AxxAxx/AxxPD/Documentation/photos/AxxPD_Schematic.png

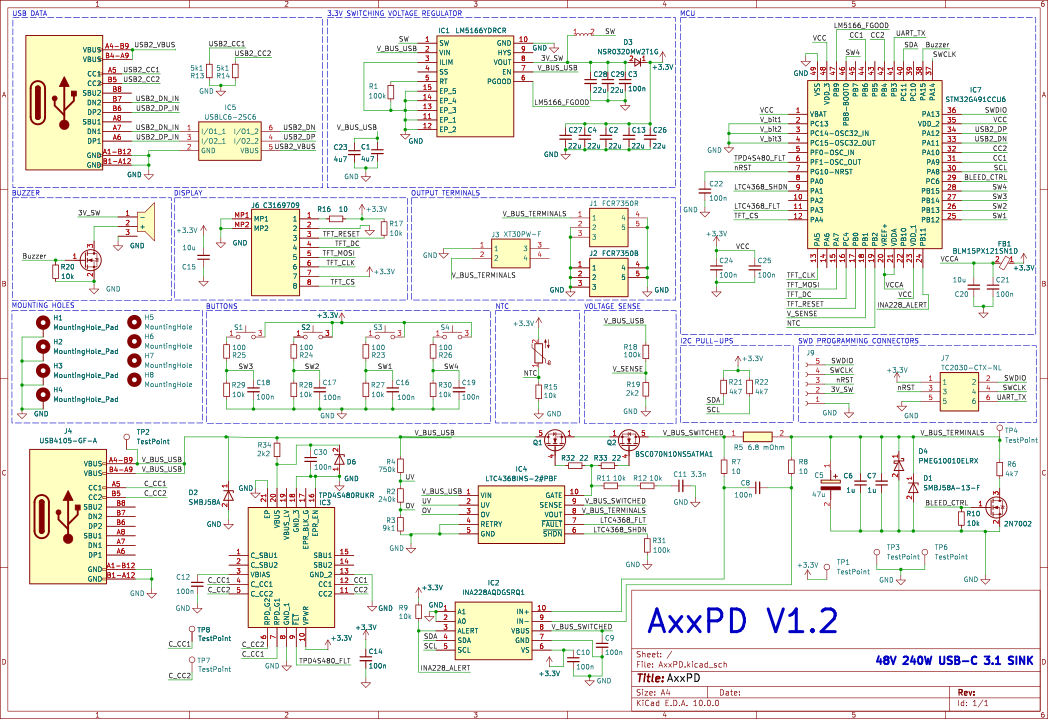
Documentation/photos/AxxPD_Schematic.png
