AxxAxx/AxxPD/Firmware/Core/Inc/main.h

#define FAULT_NONE            0
#define FAULT_INA228_OCP      1
#define FAULT_COMP_OVP        2
#define FAULT_LTC4368         3
#define FAULT_TPD4S480        4
#define FAULT_LM5166_PGOOD    5
#define FAULT_OPP             6
#define FAULT_TIMER           7
#define FAULT_AH_LIMIT        8
#define FAULT_WH_LIMIT        9
#define FAULT_CHARGE_COMPLETE 10
#define FAULT_THERMAL         11
#define FAULT_LOG_SIZE  8
#define V_BIT_1_Pin GPIO_PIN_13
#define V_BIT_1_GPIO_Port GPIOC
#define V_BIT_2_Pin GPIO_PIN_14
#define V_BIT_2_GPIO_Port GPIOC
#define V_BIT_3_Pin GPIO_PIN_15
#define V_BIT_3_GPIO_Port GPIOC
#define TPD4S480_FLT_Pin GPIO_PIN_1
#define TPD4S480_FLT_GPIO_Port GPIOF
#define LTC4368_SHDN_Pin GPIO_PIN_1
#define LTC4368_SHDN_GPIO_Port GPIOA
#define LTC4368_FLT_Pin GPIO_PIN_3
#define LTC4368_FLT_GPIO_Port GPIOA
#define TFT_CS_Pin GPIO_PIN_4
#define TFT_CS_GPIO_Port GPIOA
#define TFT_DC_Pin GPIO_PIN_4
#define TFT_DC_GPIO_Port GPIOC
#define TFT_RESET_Pin GPIO_PIN_0
#define TFT_RESET_GPIO_Port GPIOB
#define V_SENSE_Pin GPIO_PIN_1
#define V_SENSE_GPIO_Port GPIOB
#define NTC_Pin GPIO_PIN_2
#define NTC_GPIO_Port GPIOB
#define INA228_ALERT_Pin GPIO_PIN_11
#define INA228_ALERT_GPIO_Port GPIOB
#define SW_1_Pin GPIO_PIN_12
#define SW_1_GPIO_Port GPIOB
#define SW_2_Pin GPIO_PIN_13
#define SW_2_GPIO_Port GPIOB
#define SW_3_Pin GPIO_PIN_14
#define SW_3_GPIO_Port GPIOB
#define SW_4_Pin GPIO_PIN_15
#define SW_4_GPIO_Port GPIOB
#define BLEED_CTRL_Pin GPIO_PIN_6
#define BLEED_CTRL_GPIO_Port GPIOC
#define BUZZER_Pin GPIO_PIN_15
#define BUZZER_GPIO_Port GPIOA
#define LM5166_FGOOD_Pin GPIO_PIN_9
#define LM5166_FGOOD_GPIO_Port GPIOB
#define VERSION_BIT_1_Pin       V_BIT_1_Pin
#define VERSION_BIT_1_GPIO_Port V_BIT_1_GPIO_Port
#define VERSION_BIT_2_Pin       V_BIT_2_Pin
#define VERSION_BIT_2_GPIO_Port V_BIT_2_GPIO_Port
#define VERSION_BIT_3_Pin       V_BIT_3_Pin
#define VERSION_BIT_3_GPIO_Port V_BIT_3_GPIO_Port
#define BUTTON_DECREASE_Pin       SW_3_Pin
#define BUTTON_DECREASE_GPIO_Port SW_3_GPIO_Port
#define BUTTON_INCREASE_Pin       SW_2_Pin
#define BUTTON_INCREASE_GPIO_Port SW_2_GPIO_Port
#define BUTTON_SELECT_Pin         SW_1_Pin
#define BUTTON_SELECT_GPIO_Port   SW_1_GPIO_Port
#define BUTTON_POWER_Pin          SW_4_Pin
#define BUTTON_POWER_GPIO_Port    SW_4_GPIO_Port
#define LM5166_PGOOD_Pin          LM5166_FGOOD_Pin
#define LM5166_PGOOD_GPIO_Port    LM5166_FGOOD_GPIO_Port
#define OVP_DIVIDER_RATIO (2.2f / (100.0f + 2.2f))
