AxxAxx/AxxPD/Firmware/pdsink/src/pd/dpm.cpp

#include <etl/algorithm.h>

#include "dpm.h"
#include "pd_log.h"
#include "port.h"
#include "utils/dobj_utils.h"

// [AxxPD fix 2026-08-02] CMSIS intrinsics (__get_PRIMASK / __disable_irq /
// __set_PRIMASK) for the trigger-setter critical sections below.
#include "stm32g4xx.h"

namespace pd {

using namespace dobj_utils;

//
// Custom handlers. You are expected to override these in your application.
//

auto DPM::get_sink_pdo_list() -> PDO_LIST {
    // SNK demands are filled only once and MUST NOT be changed
    if (sink_pdo_list.size() > 0) { return sink_pdo_list; }

    //
    // By default, demand as much as possible. Otherwise the SRC can
    // hide some capabilities. This list does NOT depend on the SRC and
    // exists to describe SNK needs.
    //
    // NOTE: This can be just a list of uint32_t constants, but for better
    // readability we use PDO structures to fill the data.
    //

    //
    // SPR PDOs first. Fixed ones first, ordered by voltage. Then PPS.
    //

    // See [rev3.2] 6.4.1.3 Sink Power Data Objects
    SNK_PDO_FIXED pdo1{create_pdo_variant_bits(PDO_VARIANT::FIXED)};

    // PDO 1 is always vSafe5V, with extra flags to describe demands.
    // NOTE: These flags should be zero in following PDO-s
    pdo1.dual_role_power = 0; // No DRP support, Sink only
    pdo1.higher_capability = 1; // Require more power for full functionality
    pdo1.unconstrained_power = 1;
    if (has_usb_comm()) { pdo1.usb_comms_capable = 1; }
    pdo1.dual_role_data = 0; // No DFP support, UFP only
    pdo1.frs_required = 0; // No FRS support

    set_snk_pdo_limits(pdo1.raw_value, PDO_LIMITS().set_mv(5000).set_ma(3000));
    sink_pdo_list.push_back(pdo1.raw_value);

    //
    // Fill the rest of the SPR PDOs, 2...7
    //
    SNK_PDO_FIXED pdo2{create_pdo_variant_bits(PDO_VARIANT::FIXED)};
    set_snk_pdo_limits(pdo2.raw_value, PDO_LIMITS().set_mv(9000).set_ma(3000));
    sink_pdo_list.push_back(pdo2.raw_value);

    SNK_PDO_FIXED pdo3{create_pdo_variant_bits(PDO_VARIANT::FIXED)};
    set_snk_pdo_limits(pdo3.raw_value, PDO_LIMITS().set_mv(12000).set_ma(3000));
    sink_pdo_list.push_back(pdo3.raw_value);

    SNK_PDO_FIXED pdo4{create_pdo_variant_bits(PDO_VARIANT::FIXED)};
    set_snk_pdo_limits(pdo4.raw_value, PDO_LIMITS().set_mv(15000).set_ma(3000));
    sink_pdo_list.push_back(pdo4.raw_value);

    SNK_PDO_FIXED pdo5{create_pdo_variant_bits(PDO_VARIANT::FIXED)};
    set_snk_pdo_limits(pdo5.raw_value, PDO_LIMITS().set_mv(20000).set_ma(5000));
    sink_pdo_list.push_back(pdo5.raw_value);

    // PPS APDOs — minimum 3.3 V per PD spec, but many chargers only go to 5 V.
    SNK_PDO_SPR_PPS pdo6{create_pdo_variant_bits(PDO_VARIANT::APDO_PPS)};
    set_snk_pdo_limits(pdo6.raw_value,
        PDO_LIMITS().set_mv_min(5000).set_mv_max(11000).set_ma(3000));
    sink_pdo_list.push_back(pdo6.raw_value);

    SNK_PDO_SPR_PPS pdo7{create_pdo_variant_bits(PDO_VARIANT::APDO_PPS)};
    set_snk_pdo_limits(pdo7.raw_value,
        PDO_LIMITS().set_mv_min(5000).set_mv_max(21000).set_ma(5000));
    sink_pdo_list.push_back(pdo7.raw_value);

    //
    // EPR PDOs. MUST start from 8. If the SPR PDO count is < 7, the gap MUST be
    // padded with zeros. The EPR block can have up to 3 Fixed PDOs + 1 AVS.
    //

    SNK_PDO_FIXED pdo8{create_pdo_variant_bits(PDO_VARIANT::FIXED)};
    set_snk_pdo_limits(pdo8.raw_value, PDO_LIMITS().set_mv(28000).set_ma(5000));
    sink_pdo_list.push_back(pdo8.raw_value);

    SNK_PDO_FIXED pdo9{create_pdo_variant_bits(PDO_VARIANT::FIXED)};
    set_snk_pdo_limits(pdo9.raw_value, PDO_LIMITS().set_mv(36000).set_ma(5000));
    sink_pdo_list.push_back(pdo9.raw_value);

    SNK_PDO_FIXED pdo10{create_pdo_variant_bits(PDO_VARIANT::FIXED)};
    set_snk_pdo_limits(pdo10.raw_value, PDO_LIMITS().set_mv(48000).set_ma(5000));
    sink_pdo_list.push_back(pdo10.raw_value);

    SNK_PDO_EPR_AVS pdo11{create_pdo_variant_bits(PDO_VARIANT::APDO_EPR_AVS)};
    set_snk_pdo_limits(pdo11.raw_value,
        PDO_LIMITS().set_mv_min(15000).set_mv_max(48000).set_pdp(get_epr_watts()));
    sink_pdo_list.push_back(pdo11.raw_value);

    return sink_pdo_list;
}

void DPM::fill_rdo_flags(uint32_t &rdo) {
    // Fill common RDO flags here.
    // This is the default implementation. You can override it if required.

    RDO_ANY rdo_bits{rdo};

    // Mirror source PDO1 EPR bit — setting epr_capable=1 when the source
    // has EPR=0 causes a Hard Reset on strict chargers (PD 3.1 s6.4.2.4.3).
    //
    // Per USB-PD 3.1 Table 6.9 (Fixed Supply PDO – Source), bit 23 is
    // "EPR Mode Capable" (bit 22 is reserved). pdsink upstream incorrectly
    // extracts bit 22 here; use bit 23. The sink RDO's epr_capable bit is
    // at 22 (Table 6.23), so the union write below targets the correct bit.
    //
    // NOTE: we always mirror the source's bit, even when the sink doesn't
    // intend to enter EPR. Observed Anker A2697 behaviour: if our SPR
    // Request for the 20 V/5 A PDO sets epr_capable=0, Anker repeatedly
    // re-advertises Source_Capabilities instead of sending PS_RDY, in an
    // endless livelock. Declaring EPR capability truthfully (sink IS
    // EPR-capable; just not entering right now) satisfies the source.
    rdo_bits.epr_capable = (port.source_caps.size() > 0 &&
                            ((port.source_caps[0] >> 23) & 1)) ? 1 : 0;
    // Unchunked extended messages (long transfers) are NOT supported (and not
    // needed, because chunking is enough).
    // DON'T try to set this bit; it will break everything!
    rdo_bits.unchunked_ext_msg_supported = 0;
    rdo_bits.no_usb_suspend = 1;
    rdo_bits.usb_comm_capable = has_usb_comm() ? 1 : 0;

    rdo = rdo_bits.raw_value;
}

// This is called when `SRC Capabilities` and `EPR SRC Capabilities`
// are received from the power source. Returns the RDO and appropriate PDO as a pair
auto DPM::get_request_data_object(const etl::ivector<uint32_t>& src_caps) -> etl::pair<uint32_t, uint32_t> {
    // This is the default stub implementation, with simple trigger support.
    // Customize if required.

    //
    // NOTE: Here we indirectly check EPR mode. At the start we go to SPR, where
    // the EPR voltage will not be available, and we fall back to vSafe5V.
    // Then, PE will automatically upgrade to EPR (with new EPR Caps) and this
    // function will be called again.
    //

    if (src_caps.empty()) {
        DPM_LOGE("get_request_data_object: invalid SRC Caps input");
        return {0, 0};
    }

    for (uint32_t i = 0, max = src_caps.size(); i < max; i++) {
        const auto pdo = src_caps[i];
        // Skip padded positions
        if (pdo == 0) { continue; }

        const auto id = get_src_pdo_variant(pdo);
        // Skip unsupported PDO variants
        if (id == PDO_VARIANT::UNKNOWN) { continue; }

        if (trigger_match_type == TRIGGER_MATCH_TYPE::BY_POSITION)
        {
            // If the position matches, we can use it. Don't check ma/mv limits,
            // because the user asked for this position explicitly.
            // Note: position is 1-based.
            if ((i + 1) != trigger_position) { continue; }
        }
        else
        {
            if (trigger_match_type == TRIGGER_MATCH_TYPE::BY_PDO_VARIANT &&
                id != trigger_pdo_variant) { continue;}

            if (!match_limits(pdo, trigger_mv, trigger_ma)) { continue; }
        }

        // Create RDO
        RDO_ANY rdo{};
        fill_rdo_flags(rdo.raw_value);
        rdo.obj_position = i + 1; // zero-based index + 1

        // Fill PDO-specific fields (volts/current/watts)
        auto limits = get_src_pdo_limits(pdo);

        uint32_t mv = trigger_mv ? trigger_mv : limits.mv_min;
        mv = etl::clamp<uint32_t>(mv, limits.mv_min, limits.mv_max);

        uint32_t ma_limit = limits.ma ? limits.ma : (limits.pdp * 1000000U / mv);
        if (ma_limit > 5000) { ma_limit = 5000; } // clamp to 5A max PD limit

        uint32_t ma = trigger_ma ? trigger_ma : ma_limit;
        ma = etl::clamp<uint32_t>(ma, 0, ma_limit);

        switch (id) {
            case PDO_VARIANT::FIXED:
                // `mv` is always exact for FIXED PDO
                set_rdo_limits_fixed(rdo.raw_value, ma, ma);
                return {rdo.raw_value, pdo};

            case PDO_VARIANT::APDO_PPS:
                set_rdo_limits_pps(rdo.raw_value, mv, ma);
                return {rdo.raw_value, pdo};

            case PDO_VARIANT::APDO_SPR_AVS:
                set_rdo_limits_avs(rdo.raw_value, mv, ma);
                return {rdo.raw_value, pdo};

            case PDO_VARIANT::APDO_EPR_AVS:
                set_rdo_limits_avs(rdo.raw_value, mv, ma);
                return {rdo.raw_value, pdo};

            default:
                DPM_LOGE("get_request_data_object: unsupported PDO variant");
                break;
        }
    }

    // By default, return vSafe5V based on the first entry in the SRC capabilities
    const auto pdo = src_caps[0];
    RDO_FIXED rdo{};
    fill_rdo_flags(rdo.raw_value);
    rdo.obj_position = 0 + 1; // Position = zero-based index + 1

    auto limits = get_src_pdo_limits(pdo);
    set_rdo_limits_fixed(rdo.raw_value, limits.ma, limits.ma);
    return {rdo.raw_value, pdo};
}

void DPM::request_new_power_level() {
    // Only if an explicit contract exists.
    // If not, the data will be used at the handshake.
    if (port.pe_flags.test(PE_FLAG::HAS_EXPLICIT_CONTRACT)) {
        port.dpm_requests.set(DPM_REQUEST_FLAG::NEW_POWER_LEVEL);
        // Don't call wakeup(); keep execution in the driver's "thread".
        // Rely on the timer's periodic tick to catch the request.
    }
}

// [AxxPD fix 2026-08-02] The PD state machine runs from the SysTick ISR and
// reads the trigger_* fields in get_request_data_object(); if that ISR fires
// mid-update here (or an unsolicited Source_Capabilities arrives), it can
// build an RDO from a half-written trigger set and request the wrong voltage.
// Both setters therefore write the field group inside a short PRIMASK
// critical section. The atomic NEW_POWER_LEVEL flag is set afterwards, in
// request_new_power_level(), so the fields are fully visible before the PE
// acts on the request.

void DPM::trigger_variant(PDO_VARIANT pdo_variant, uint32_t mv, uint32_t ma) {
    uint32_t primask = __get_PRIMASK();
    __disable_irq();
    trigger_mv = mv;
    trigger_ma = ma;
    trigger_pdo_variant = pdo_variant;
    trigger_position = 0;
    trigger_match_type = (pdo_variant == PDO_VARIANT::UNKNOWN)
        ? TRIGGER_MATCH_TYPE::USE_ANY
        : TRIGGER_MATCH_TYPE::BY_PDO_VARIANT;
    __set_PRIMASK(primask);
    request_new_power_level();
}

void DPM::trigger_by_position(uint8_t position, uint32_t mv, uint32_t ma) {
    uint32_t primask = __get_PRIMASK();
    __disable_irq();
    trigger_mv = mv;
    trigger_ma = ma;
    trigger_match_type = TRIGGER_MATCH_TYPE::BY_POSITION;
    trigger_position = position;
    trigger_pdo_variant = PDO_VARIANT::UNKNOWN; // not used in this mode
    __set_PRIMASK(primask);
    request_new_power_level();
}

} // namespace pd
