AxxAxx/AxxPD/Firmware/pdsink/src/pd/data_objects.h

#pragma once

#include <etl/endianness.h>
#include <etl/message.h>
#include <etl/vector.h>
#include <stdint.h>

static_assert(etl::endianness::value() == etl::endian::little,
    "Only little-endian targets are supported");

namespace pd {

constexpr int MaxExtendedMsgLen = 260;
constexpr int MaxExtendedMsgChunkLen = 26;
constexpr int MaxExtendedMsgLegacyLen = 26;
constexpr int MaxChunksPerMsg = 10;

constexpr int MaxPdoObjects = 11; // 11 for EPR mode.
constexpr int MaxPdoObjects_SPR = 7; // 7 for SPR mode.
constexpr int MaxUnchunkedMsgLen = 28;

constexpr int nHardResetCount = 2;
constexpr int nRetryCount = 2;
constexpr int nRetryCount_REV20 = 3;

namespace PD_REVISION {
    enum Type {
        REV10 = 0,
        REV20 = 1,
        REV30 = 2
    };
}; // namespace PD_REVISION

// NOTE: Redefine if you implement an option to build without full PRL support.
constexpr auto MaxSupportedRevision = PD_REVISION::REV30;

using PDO_LIST = etl::vector<uint32_t, MaxPdoObjects>;

namespace PD_PACKET_TYPE {
    enum Type {
        SOP = 0,
        SOP_PRIME = 1,
        SOP_PRIME_PRIME = 2,
        SOP_DEBUG_PRIME = 3,
        SOP_DEBUG_PRIME_PRIME = 4,

        INVALID = 0xf
    };
}; // namespace PD_PACKET_TYPE


// 6.3 Control Message
// Table 6.5 Control Message Types
namespace PD_CTRL_MSGT {
    enum Type {
        GoodCRC = 1,
        GotoMin = 2, // Deprecated
        Accept = 3,
        Reject = 4,
        Ping = 5, // Deprecated
        PS_RDY = 6,
        Get_Source_Cap = 7,
        Get_Sink_Cap = 8,
        DR_Swap = 9,
        PR_Swap = 10,
        VCONN_Swap = 11,
        Wait = 12,
        Soft_Reset = 13,
        // rev 3+
        Data_Reset = 14,
        Data_Reset_Complete = 15,
        Not_Supported = 16,
        Get_Source_Cap_Ext = 17,
        Get_Status = 18,
        FR_Swap = 19,
        Get_PPS_Status = 20,
        Get_Country_Codes = 21,
        Get_Sink_Cap_Extended = 22,
        Get_Source_Info = 23,
        Get_Revision = 24,
        // Reserved 25-31
    };
}; // namespace PD_CTRL_MSGT


// 6.4 Data Message
// Table 6.6 Data Message Types
namespace PD_DATA_MSGT {
    enum Type {
        Source_Capabilities = 1,
        Request = 2,
        BIST = 3,
        Sink_Capabilities = 4,
        Battery_Status = 5,
        Alert = 6,
        Get_Country_Info = 7,
        Enter_USB = 8,
        EPR_Request = 9,
        EPR_Mode = 10,
        Source_Info = 11,
        Revision = 12,
        // Reserved 13-14
        Vendor_Defined = 15,
        // Reserved 16-31
    };
}; // namespace PD_DATA_MSGT


// 6.5 Extended Message
// Table 6.53 Extended Message Types
namespace PD_EXT_MSGT {
    enum Type {
        // 0 reserved
        Source_Capabilities_Extended = 1,
        Status = 2,
        Get_Battery_Cap = 3,
        Get_Battery_Status = 4,
        Battery_Capabilities = 5,
        Get_Manufacturer_Info = 6,
        Manufacturer_Info = 7,
        Security_Request = 8,
        Security_Response = 9,
        Firmware_Update_Request = 10,
        Firmware_Update_Response = 11,
        PPS_Status = 12,
        Country_Info = 13,
        Country_Codes = 14,
        Sink_Capabilities_Extended = 15,
        Extended_Control = 16,
        EPR_Source_Capabilities = 17,
        EPR_Sink_Capabilities = 18,
        // Reserved 19-29
        Vendor_Defined_Extended = 30,
        // Reserved 31
    };
};


// 6.2.1.1 Message Header
union PD_HEADER {
    uint16_t raw_value;
    struct {
        uint16_t message_type : 5;
        uint16_t port_data_role : 1; // SOP only, Reserved for SOP'/SOP"
        uint16_t spec_revision : 2;
        uint16_t port_power_role : 1; // SOP only, Cable plug for SOP'/SOP"
        uint16_t message_id : 3;
        uint16_t data_obj_count : 3; // Number of data objects in the message
        uint16_t extended : 1;
    };
};


// 6.2.1.2 Extended Message Header
union PD_EXT_HEADER {
    uint16_t raw_value;
    struct {
        uint16_t data_size : 9;
        uint16_t : 1; // reserved
        uint16_t request_chunk : 1;
        uint16_t chunk_number : 4;
        uint16_t chunked : 1;
    };
};

union PD_ALERT {
    uint32_t raw_value;
    struct {
        uint32_t ext_type : 4;
        uint32_t : 12; // reserved
        uint32_t hot_swappable_batteries : 4;
        uint32_t fixed_batteries : 4;
        // Alert bits
        uint32_t : 1; // reserved
        uint32_t battery_status_change : 1;
        uint32_t ocp : 1;
        uint32_t otp : 1;
        uint32_t operating_condition_change : 1;
        uint32_t source_input_change : 1;
        uint32_t ovp : 1;
        uint32_t extended : 1;
    };
};


//
// [rev3.2] 6.4.1.1 Power Data Objects
//
// Only actually usable ones defined below
//

// Bits 30..31
namespace PDO_TYPE {
    enum {
        FIXED = 0,
        // NOTE: VARIABLE and BATTERY IDs seem swapped in SNK PDO,
        // spec 3.2 rev 1.1. Be careful if you decide to add support.
        AUGMENTED = 3
    };
}; // namespace PDO_TYPE

// Bits 28..29 for APDO
namespace PDO_AUGMENTED_SUBTYPE {
    enum {
        SPR_PPS = 0,
        // Supported from PD 3.1
        EPR_AVS = 1,
        // Supported from PD 3.2
        SPR_AVS = 2
    };
}; // namespace PDO_AUGMENTED_SUBTYPE

// Supported PDO variants for PDO utilities & dpm. Reflect PDO type + subtype.
// Not from spec, but simplify things.
enum class PDO_VARIANT {
    UNKNOWN,
    FIXED,
    APDO_PPS,
    APDO_SPR_AVS,
    APDO_EPR_AVS
};

// [rev3.2] 6.4.1.2.1 Fixed Supply Power Data Object
// Table 6.9
union PDO_FIXED {
    uint32_t raw_value;
    struct {
        uint32_t max_current : 10; // 10ma step
        uint32_t voltage : 10; // 50mv step
        uint32_t peak_current: 2; // ??
        uint32_t : 1;
        uint32_t epr_capable : 1;
        uint32_t unchunked_ext_msg_supported : 1;
        uint32_t dual_role_data : 1;
        uint32_t usb_comms_capable : 1;
        uint32_t unconstrained_power : 1;
        uint32_t usb_suspend_supported : 1; // For SNK RDO means "Higher Capability"
        uint32_t dual_role_power : 1;
        uint32_t pdo_type : 2;
    };
};

// [rev3.2] 6.4.1.2.4 Augmented Power Data Object (APDO)
// Table 6.13
union PDO_SPR_PPS {
    uint32_t raw_value;
    struct {
        uint32_t max_current: 7; // 50ma step
        uint32_t : 1;
        uint32_t min_voltage : 8; // 100mv step
        uint32_t : 1;
        uint32_t max_voltage : 8; // 100mv step
        uint32_t : 2;
        uint32_t pps_power_limited : 1;
        uint32_t apdo_subtype : 2; // 00b
        uint32_t pdo_type : 2; // 11b
    };
};

// [rev3.2] Table 6.14 SPR Adjustable Voltage Supply APDO
union PDO_SPR_AVS {
    uint32_t raw_value;
    struct {
        uint32_t max_current_20v: 10; // 15-20V range, 10ma step
        uint32_t max_current_15v : 10; // 9-15V range, 10ma step
        uint32_t : 6;
        uint32_t peak_current : 2;
        uint32_t apdo_subtype : 2; // 10b
        uint32_t pdo_type : 2; // 11b
    };
};

// [rev3.2] Table 6.15
union PDO_EPR_AVS {
    uint32_t raw_value;
    struct {
        uint32_t pdp: 8; // 1W step
        uint32_t min_voltage : 8; // 100mv step
        uint32_t : 1;
        uint32_t max_voltage : 9; // 100mv step
        uint32_t peak_current : 2;
        uint32_t apdo_subtype : 2; // 01b
        uint32_t pdo_type : 2; // 11b
    };
};

//
// Request Data Objects ([rev3.2] 6.4.2 Request Message)
//
// Only actually usable ones defined below
//

// [rev3.2] Table 6.23 Fixed and Variable Request Data Object
union RDO_FIXED {
    uint32_t raw_value;
    struct {
        uint32_t max_current : 10; // 10ma step
        uint32_t operating_current : 10; // 10ma step
        uint32_t : 2;
        uint32_t epr_capable : 1;
        uint32_t unchunked_ext_msg_supported : 1;
        uint32_t no_usb_suspend : 1;
        uint32_t usb_comm_capable : 1;
        uint32_t capability_mismatch : 1;
        uint32_t : 1; // "giveback" flag deprecated
        uint32_t obj_position : 4; // !!! numeration starts from 1 !!!
    };
};

// [rev3.2] Table 6.25 PPS Request Data Object
union RDO_PPS {
    uint32_t raw_value;
    struct {
        uint32_t operating_current : 7; // 50ma step
        uint32_t : 2;
        uint32_t output_voltage : 12; // 20mv step
        uint32_t : 1;
        uint32_t epr_capable : 1;
        uint32_t unchunked_ext_msg_supported : 1;
        uint32_t no_usb_suspend : 1;
        uint32_t usb_comm_capable : 1;
        uint32_t capability_mismatch : 1;
        uint32_t : 1; // "giveback" flag deprecated
        uint32_t obj_position : 4; // !!! numeration starts from 1 !!!
    };
};

// [rev3.2] Table 6.26 AVS Request Data Object
// Exactly the same as RDO_PPS in spec 3.2, but `output voltage` is a bit different
union RDO_AVS {
    uint32_t raw_value;
    struct {
        uint32_t operating_current : 7; // 50ma step
        uint32_t : 2;
        uint32_t output_voltage : 12; // 25mv step, least 2 bits MUST be 00
        uint32_t : 1;
        uint32_t epr_capable : 1;
        uint32_t unchunked_ext_msg_supported : 1;
        uint32_t no_usb_suspend : 1;
        uint32_t usb_comm_capable : 1;
        uint32_t capability_mismatch : 1;
        uint32_t : 1; // "giveback" flag deprecated
        uint32_t obj_position : 4; // !!! numeration starts from 1 !!!
    };
};

// [rev3.2] Table 6.26 AVS Request Data Object
// Skipped for now. Exactly the same as RDO_PPS in spec 3.2

// Helper to parse flags
union RDO_ANY {
    uint32_t raw_value;
    struct {
        uint32_t : 22; // depends on PDO type
        uint32_t epr_capable : 1;
        uint32_t unchunked_ext_msg_supported : 1;
        uint32_t no_usb_suspend : 1;
        uint32_t usb_comm_capable : 1;
        uint32_t capability_mismatch : 1;
        uint32_t : 1; // "giveback" flag deprecated
        uint32_t obj_position : 4; // !!! numeration starts from 1 !!!
    };
};

//
// SNK PDO objects, to describe Sink demands
//

// [rev3.2] 6.4.1.3.1 Sink Fixed Supply Power Data Object
// Table 6.17
union SNK_PDO_FIXED {
    uint32_t raw_value;
    struct {
        uint32_t max_current : 10; // 10ma step
        uint32_t voltage : 10; // 50mv step
        uint32_t : 2;
        uint32_t frs_required : 2;
        uint32_t dual_role_data : 1;
        uint32_t usb_comms_capable : 1;
        uint32_t unconstrained_power : 1;
        uint32_t higher_capability : 1;
        uint32_t dual_role_power : 1;
        uint32_t pdo_type : 2; //
    };
};

// [rev3.2] 6.4.1.3.4.1 SPR Programmable Power Supply APDO
// Table 6.20
union SNK_PDO_SPR_PPS {
    uint32_t raw_value;
    struct {
        uint32_t max_current: 7; // 50ma step
        uint32_t : 1;
        uint32_t min_voltage : 8; // 100mv step
        uint32_t : 1;
        uint32_t max_voltage : 8; // 100mv step
        uint32_t : 3;
        uint32_t apdo_subtype : 2; // 00b
        uint32_t pdo_type : 2; // 11b
    };
};

// [rev3.2] 6.4.1.3.4.2 SPR Adjustable Voltage Supply APDO
// Table 6.21
union SNK_PDO_SPR_AVS {
    uint32_t raw_value;
    struct {
        uint32_t max_current_20v: 10; // 15-20V range, 10ma step
        uint32_t max_current_15v : 10; // 9-15V range, 10ma step
        uint32_t : 8;
        uint32_t apdo_subtype : 2; // 10b
        uint32_t pdo_type : 2; // 11b
    };
};

// [rev3.2] 6.4.1.3.4.3 EPR Adjustable Voltage Supply APDO
// Table 6.22
union SNK_PDO_EPR_AVS {
    uint32_t raw_value;
    struct {
        uint32_t pdp: 8; // 1W step
        uint32_t min_voltage : 8; // 100mv step
        uint32_t : 1;
        uint32_t max_voltage : 9; // 100mv step
        uint32_t : 2;
        uint32_t apdo_subtype : 2; // 01b
        uint32_t pdo_type : 2; // 11b
    };
};

namespace EPR_MODE_ACTION {
    enum Type {
        ENTER = 1,
        ENTER_ACKNOWLEDGED = 2,
        ENTER_SUCCEEDED = 3,
        ENTER_FAILED = 4,
        EXIT = 5
    };
}; // namespace EPR_MODE_ACTION

// [rev3.2] Table 6.50 EPR Mode Data Object (EPRMDO)
union EPRMDO {
    uint32_t raw_value;
    struct {
        uint32_t : 16;
        uint32_t data : 8;
        uint32_t action : 8;
    };
};

// [rev3.2] 6.5.14 Extended_Control Message
union ECDB {
    uint16_t raw_value;
    struct {
        uint16_t type : 8;
        uint16_t data : 8;
    };
};

// [rev3.2] 6.5.14 Extended_Control Message
namespace PD_EXT_CTRL_MSGT {
    enum type {
        EPR_Get_Source_Cap = 1,
        EPR_Get_Sink_Cap = 2,
        EPR_KeepAlive = 3,
        EPR_KeepAlive_Ack = 4
    };
}; // namespace PD_EXT_CTRL_MSGT

// [rev3.2] 6.4.12 Revision Message
// Table 6.52 Revision Message Data Object (RMDO)
union RMDO {
    uint32_t raw_value;
    struct {
        uint32_t : 16;
        uint32_t ver_minor : 4;
        uint32_t ver_major : 4;
        uint32_t rev_minor : 4;
        uint32_t rev_major : 4;
    };
};

// [rev3.2] 6.4.3 BIST Message
namespace BIST_MODE {
    enum Type {
        Carrier = 5,
        TestData = 8,
        SharedCapacityEnter = 9,
        SharedCapacityExit = 10,
    };
}; // namespace BIST_MODE

union BISTDO {
    uint32_t raw_value;
    struct {
        uint32_t : 28;
        uint32_t mode : 4;
    };
};


class I_PD_MSG {
public:
    PD_HEADER header;

    virtual etl::ivector<uint8_t>& get_data() = 0;
    virtual const etl::ivector<uint8_t>& get_data() const = 0;
    virtual void clear() = 0;

    virtual bool is_data_msg(uint8_t type) const = 0;
    virtual bool is_ctrl_msg(uint8_t type) const = 0;
    virtual bool is_ext_msg(uint8_t type) const = 0;
    virtual bool is_ext_ctrl_msg(uint8_t type) const = 0;

    virtual uint16_t read16(size_t pos) const = 0;
    virtual uint32_t read32(size_t pos) const = 0;
    virtual void append16(uint16_t value) = 0;
    virtual void append32(uint32_t value) = 0;

    virtual void append_from(const I_PD_MSG& src, uint32_t start, uint32_t end) = 0;
    virtual uint32_t data_size() const = 0;
    virtual void resize_by_data_obj_count() = 0;
    virtual uint16_t size_to_pdo_count() const = 0;

    virtual ~I_PD_MSG() = default;
};

template <int BufferSize>
struct PD_MSG_TPL : public I_PD_MSG {
    etl::vector<uint8_t, BufferSize> _buffer;
    static constexpr size_t MAX_SIZE = BufferSize;

    etl::ivector<uint8_t>& get_data() override { return _buffer; }
    const etl::ivector<uint8_t>& get_data() const override { return _buffer; }

    PD_MSG_TPL() = default;

    PD_MSG_TPL(const I_PD_MSG& src) {
        *this = src;
    }

    PD_MSG_TPL& operator=(const I_PD_MSG& src) {
        if (this == &src) return *this;

        header = src.header;

        const auto& src_data = src.get_data();
        size_t copy_size = (src_data.size() < BufferSize) ? src_data.size() : BufferSize;
        _buffer.assign(src_data.begin(), src_data.begin() + copy_size);

        return *this;
    }

    void clear() override {
        header.raw_value = 0;
        _buffer.clear();
    }

    bool is_data_msg(uint8_t type) const override {
        return header.extended == 0 && header.data_obj_count > 0 &&
            header.message_type == type;
    }
    bool is_ctrl_msg(uint8_t type) const override {
        return header.extended == 0 && header.data_obj_count == 0 &&
            header.message_type == type;
    }
    bool is_ext_msg(uint8_t type) const override {
        return header.extended > 0 && header.message_type == type;
    }
    bool is_ext_ctrl_msg(uint8_t type) const override {
        if (!is_ext_msg(PD_EXT_MSGT::Extended_Control) || _buffer.size() < 2) {
            return false;
        }
        ECDB ecdb{read16(0)};
        return ecdb.type == type;
    }

    // Helpers to simplify payload access
    uint16_t read16(size_t pos) const override {
        size_t size = _buffer.size();
        // Bounds check is not needed, but it exists to suppress warnings from
        // code checkers. In reality, RX messages are padded in PRL.
        return uint16_t((pos >= size) ? 0 : _buffer[pos]) |
            (uint16_t((pos + 1 >= size) ? 0 : _buffer[pos + 1]) << 8);
    }
    uint32_t read32(size_t pos) const override {
        size_t size = _buffer.size();
        return uint32_t((pos >= size) ? 0 : _buffer[pos]) |
            (uint32_t((pos + 1 >= size) ? 0 : _buffer[pos + 1]) << 8) |
            (uint32_t((pos + 2 >= size) ? 0 : _buffer[pos + 2]) << 16) |
            (uint32_t((pos + 3 >= size) ? 0 : _buffer[pos + 3]) << 24);
    }

    void append16(uint16_t value) override {
        if (_buffer.available() > 0) { _buffer.push_back(value & 0xff); }
        if (_buffer.available() > 0) { _buffer.push_back((value >> 8) & 0xff); }
    }
    void append32(uint32_t value) override {
        append16(value & 0xffff);
        append16((value >> 16) & 0xffff);
    }

    void append_from(const I_PD_MSG& src, uint32_t start, uint32_t end) override {
        // Bounds check is not needed, but it exists to suppress warnings from code checkers.
        auto available = _buffer.available();

        if (end > src.data_size()) { end = src.data_size(); }
        if (start >= end) { return; }
        if (available == 0) { return; }
        if (end - start > available) { end = start + available; }

        _buffer.insert(_buffer.end(), src.get_data().begin() + start, src.get_data().begin() + end);
    }

    uint32_t data_size() const override {
        return _buffer.size();
    }

    void resize_by_data_obj_count() override {
        // [AxxPD fix 2026-08-01] Clamp to buffer capacity: etl::vector::resize
        // is unchecked in this build, so a header.data_obj_count derived from a
        // malformed/unexpected message could resize past the buffer and corrupt
        // adjacent memory. A well-formed message never exceeds capacity, so a
        // valid resize is unaffected.
        size_t n = static_cast<size_t>(header.data_obj_count) * 4u;
        if (n > _buffer.max_size()) { n = _buffer.max_size(); }
        _buffer.resize(n);
    }

    uint16_t size_to_pdo_count() const override {
        return static_cast<uint16_t>((_buffer.size() + 3) / 4); // 4 bytes per PDO
    }
};

using PD_MSG = PD_MSG_TPL<MaxExtendedMsgLen>;
using PD_CHUNK = PD_MSG_TPL<MaxUnchunkedMsgLen>;

// [AxxPD fix 2026-08-01] Lock the invariant the RX path relies on: the 3-bit
// data_obj_count (max 7 → 28 bytes) must fit in the unchunked chunk buffer.
static_assert(MaxUnchunkedMsgLen >= ((1u << 3) - 1u) * 4u,
              "PD_CHUNK buffer too small for max data_obj_count");

} // namespace pd
