AxxAxx/AxxPD/(commit log)

2026-06-04 Fix bug in initial firmware
    [boot_selector.c, buttons.c, buzzer.c, cli.cpp, dpm.cpp, graph.c, ina228.c, main.c]
2026-06-12 CDC: drop TX when no host has the port open (DTR) - fixes PD stack stalls
2026-06-12 Remove 5s edit-mode auto-cancel timer
2026-06-12 Selftest: bleed on during run so measurements track down-steps
2026-06-12 Louder button click beeps
2026-06-12 Docs: update README and command reference for current behavior
2026-06-12 Fix missed and doubled button presses
    [buttons.c, main.c]
2026-06-12 Warn on screen when corrupt settings were reset to defaults
    [settings.c, ui.c]
2026-06-12 NTC: treat out-of-range resistance as sensor fault
2026-06-12 Licensing: correct CMSIS/uGUI license info, add SPDX headers
    [boot_selector.h, buttons.c, buttons.h, buzzer.c, buzzer.h, graph.c, graph.h, ina228.c]
2026-06-12 Show 4 significant digits for voltage on Graph and Energy screens
2026-06-13 HW version: offset straps +1 so first board reports rev 1
2026-06-15 Fix bugs and update README and documentation
    [atomic_ops.c, axxpd_main.cpp, axxpd_main.h, boot_selector.c, boot_selector.h, buttons.c, buzzer.c, buzzer.h]
2026-06-18 fix fault screen redraw and ocp retry race
    [main.c, ui.c]
2026-06-18 harden ina228 i2c recovery
2026-06-18 fix opc stale-contract check
    [axxpd_main.cpp]
2026-06-21 update schematic image
    update schematic image
2026-07-31 Fix EPR boot bootloop; add standalone feature test
    [axxpd_selftest_full.py, main.c]
2026-08-01 harden protection: fault-handler safe-off, reset-cause guard, sw OVP
    [cli.cpp, main.c]
2026-08-01 fix pdsink: source_caps overflow, EPR + sender-response timers
    [pe.cpp, prl.cpp]
2026-08-01 sync docs to firmware; document button-hold DFU
2026-08-01 tools: VID:PID port match, negative current, safe cleanup
2026-08-01 guard unchecked PD buffer writes (timer id, msg resize)
2026-08-01 clamp chunked-msg resize locally; assert chunk buffer size
2026-08-01 handover: correct CC dead-battery hand-off, charger-hang mechanism
2026-08-01 handover: never-hang-the-charger investigation and layered plan
2026-08-01 harden afsm dispatch: reset on corrupt table pointer
    [main.c]
2026-08-02 revert afsm dispatch guard (false positive: interceptor table is RAM)
    [main.c]
2026-08-02 makefile: track header deps (-MMD) to stop stale incremental builds
2026-08-02 graph: restore smooth 1px-per-sample scroll (241 pts, sample-cadence blit)
2026-08-02 readme: tighten and correct (smooth graph, flash %, SWD cmd)
2026-08-02 pre-release bug-hunt fixes: brick recovery, OVP hold, PD races, updater UX
    [bl_main.c, cli.cpp, dpm.cpp, lcd.c, main.c, settings.c, ucpd_driver.cpp, ui.c]
2026-08-03 docs: 53/53 verified on hardware; EPR retry + shared-charger lesson
2026-08-07 graph: autoscale current setting (Display menu); axxpd_fwup.py CLI updater; v1.1.0
2026-08-29 ui: black tool screens, hide cable info, 2-decimal PD currents
